G10v4nn/PPSE_Board_Code/Code/note.txt

un solo sampling rate per tutti i sensori

led accensione ogni 1/8
come salvare i dati #define max = 100
vettore struct {
    data ora sempre * +2 e data per ora legale o no

    cordinate se disponibile
    gradi 1 nord
    gradi 2 est
    altitudine

    acc x
    acc y
    acc z

    temperatura fissa
}

#define max_rate 1hr
#define min_rate 1s
sampling rate 1 ogni s 

struct dati take_data_from_GPS(){

}

struct dati take_data_from_ACC(){

}

int take_data_from_TEMP(){

}

cambiare sensibilità bottoni per sampling rate

buzzer
led
schermo da finire
USB
salvataggio stringa

Esempio sprintf:
void print_register(ICM_20948_Reg_Addr_e reg_address) {
	char buff[DIM];
	memset(buff, 0x00, DIM*sizeof(uint8_t));
	ret = HAL_I2C_Mem_Read(&hi2c1, IMU_ADDR, reg_address, 1 , (uint8_t*)buff, 1, HAL_MAX_DELAY);
	while(HAL_I2C_IsDeviceReady(&hi2c1, IMU_ADDR, 1, HAL_MAX_DELAY) != HAL_OK);
	ret = sprintf((char*)buff, "data reg: 0x%x \r\n", buff[0]);
	HAL_UART_Transmit(&huart2, (uint8_t*)buff, strlen((char*)buff), HAL_MAX_DELAY);
}
