G10v4nn/PPSE_Board_Code/PCB/PSE_RP2040/PSE_RP2040.kicad_pcb

## KiCad design PCB/PSE_RP2040/PSE_RP2040.kicad_pcb (2023-07-24)

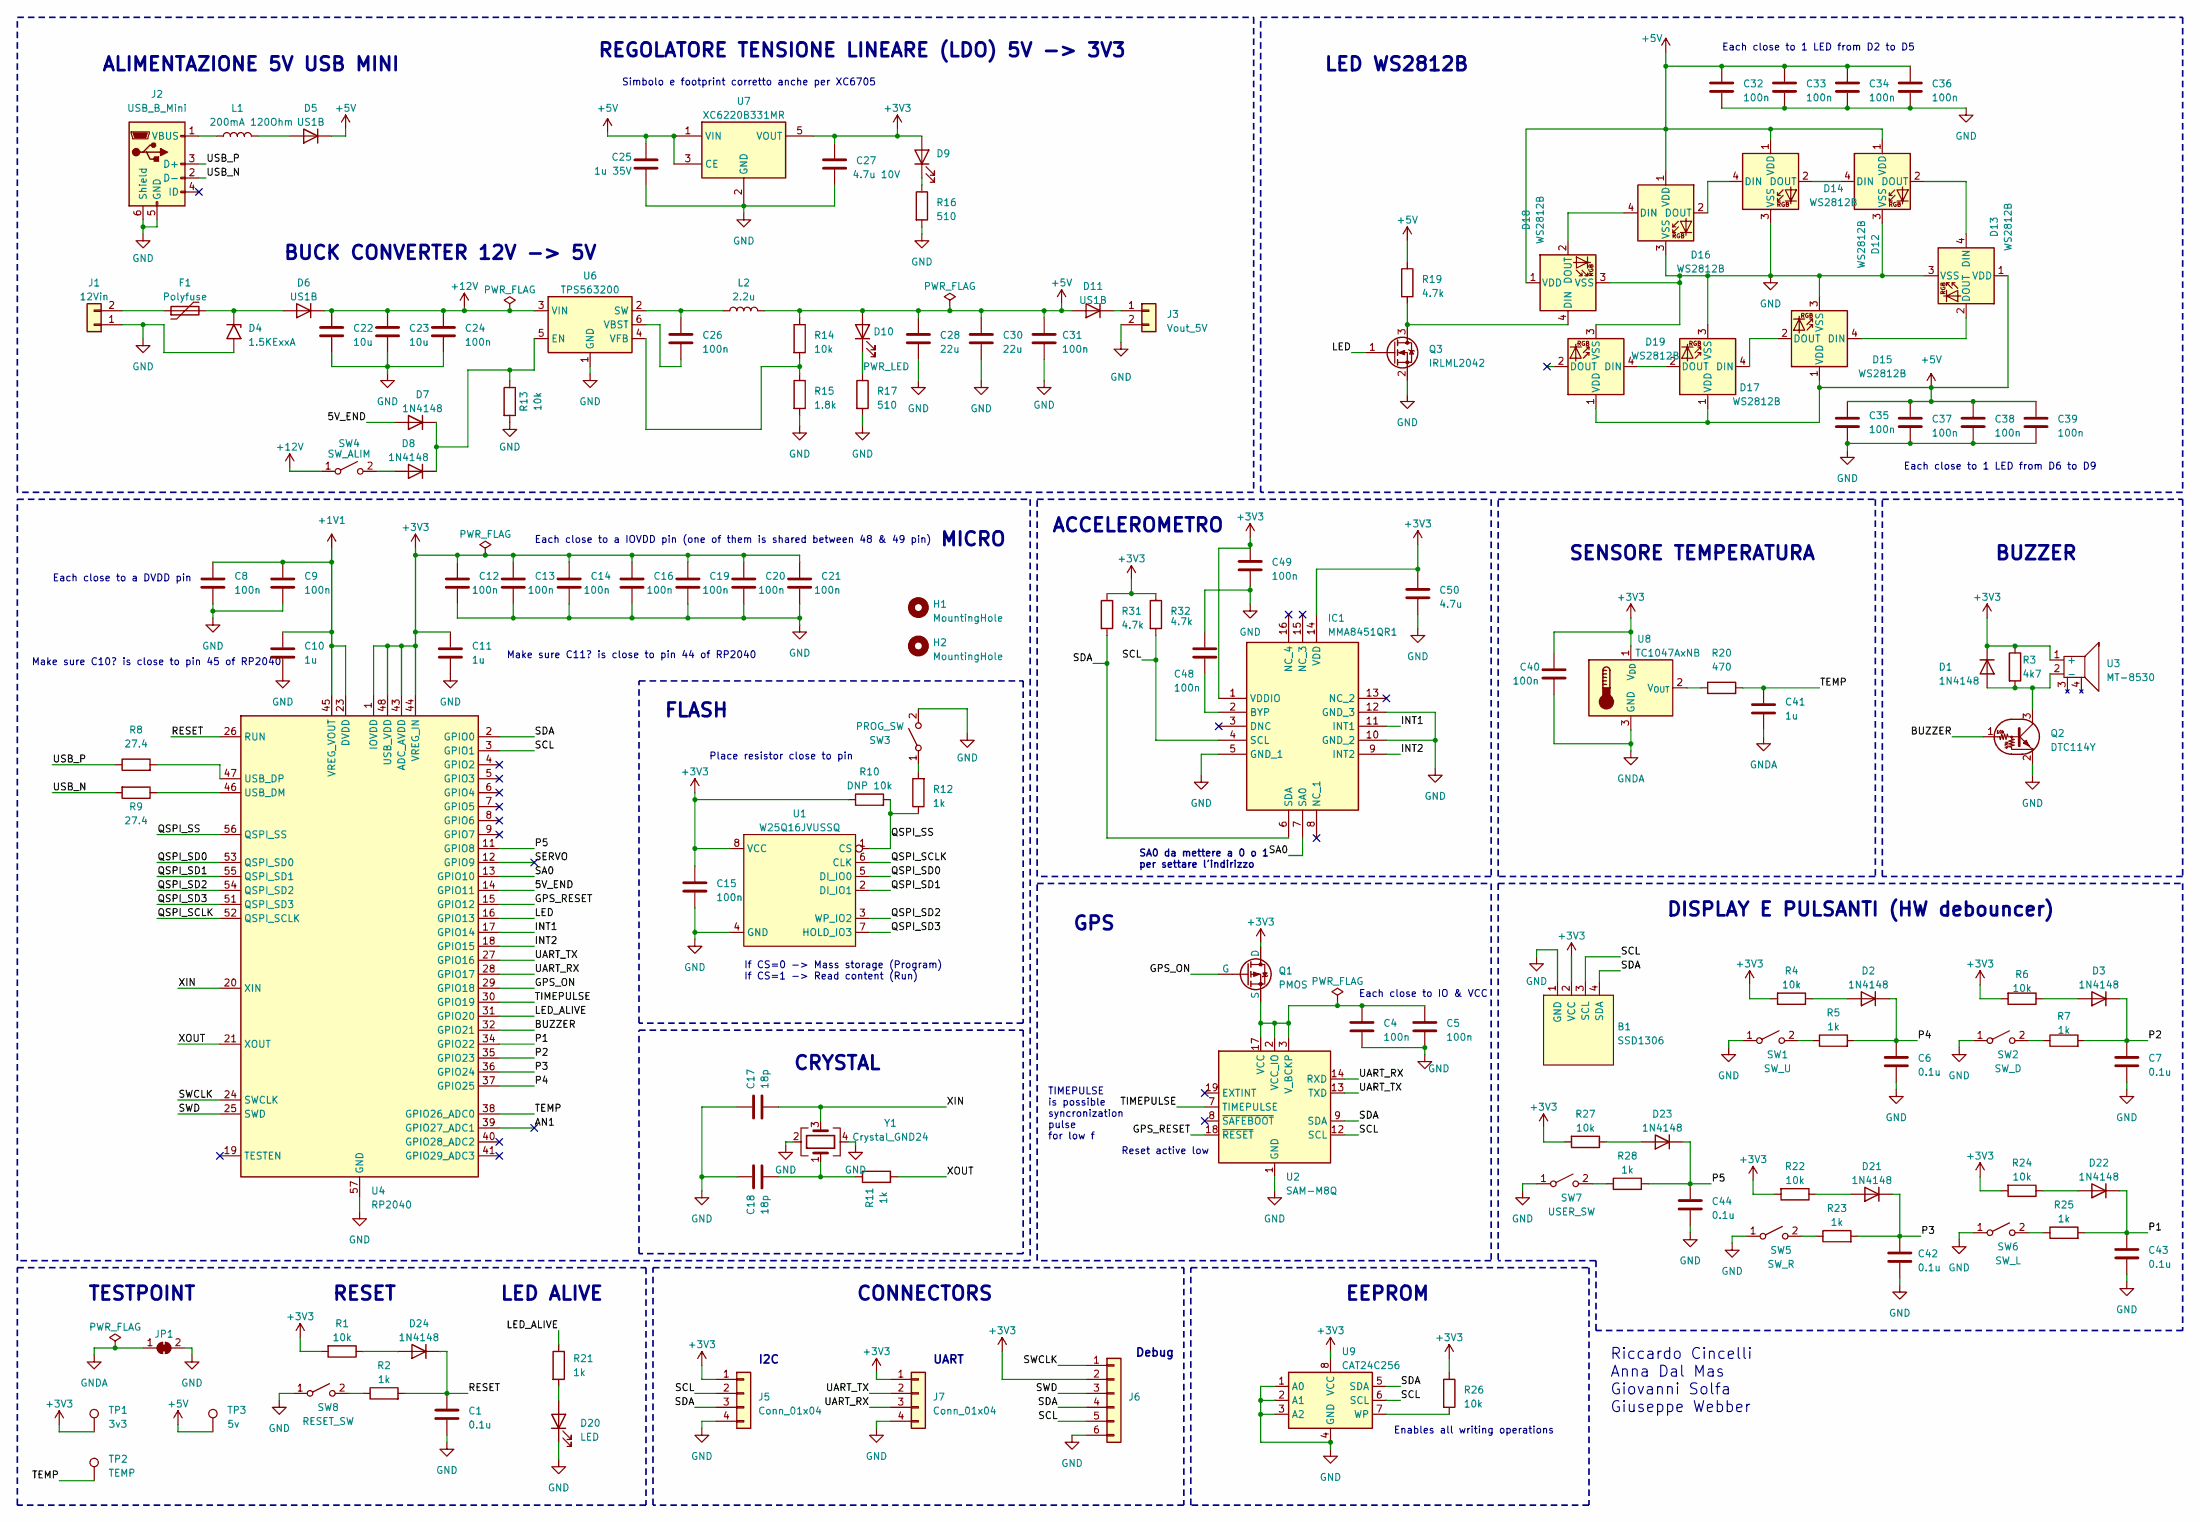
[picture p50: schematic PSE_RP2040.kicad_sch]

Parts:
B1: SSD1306; 128x64OLED
C1, C6, C7, C42, C43, C44: 0.1u; C_0603_1608Metric
C4, C5, C8, C9, C12, C13, C14, C15, C16, C19, C20, C21, C24, C26, C31, C32, C33, C34, C35, C36, C37, C38, C39, C40, C48, C49: 100n; C_0603_1608Metric
C10, C11, C41: 1u; C_0603_1608Metric
C17, C18: 18p; C_0603_1608Metric
C22, C23: 10u; CP_Radial_D6.3mm_P2.50mm
C25: 1u 35V; CP_Radial_D6.3mm_P2.50mm
C27: 4.7u 10V; CP_Radial_D6.3mm_P2.50mm
C28, C30: 22u; C_0603_1608Metric
C50: 4.7u; C_0603_1608Metric
D1, D2, D3, D7, D8, D21, D22, D23, D24: 1N4148; Nexperia_CFP3_SOD-123W
D4: 1.5KExxA; D_SMC
D5, D6, D11: US1B; D_SMA
D9, D10: PWR_LED; LED_0603_1608Metric
D12, D13, D14, D15, D16, D17, D18, D19: WS2812B; LED_WS2812B_PLCC4_5.0x5.0mm_P3.2mm
D20: LED; LED_0603_1608Metric
F1: Polyfuse; FUSC5141X200N
H1, H2: MountingHole; MountingHole_3mm
IC1: MMA8451QR1; MMA8452QT; Manufacturer_Part_Number MMA8451QR1; Mouser Part Number 841-MMA8451QR1
J1: 12Vin; 282834-2_1
J2: USB_B_Mini; USB_Mini-B_Wuerth_65100516121_Horizontal
J3: Vout_5V; 282834-2_1
J5, J7: Conn_01x04; PinSocket_1x04_P2.54mm_Vertical
J6: Conn_01x06; PinSocket_1x06_P2.54mm_Vertical
JP1: SolderJumper_2_Bridged; SolderJumper-2_P1.3mm_Bridged_Pad1.0x1.5mm
L1: 200mA 120Ohm; L_0603_1608Metric
L2: 2.2u; LQH44PN100MJ0L
Q1: PMOS; SOT95P237X112-3N
Q2: DTC114Y; SOT-23
Q3: IRLML2042; SOT-23
R1, R4, R6, R13, R14, R22, R24, R26, R27: 10k; R_0603_1608Metric
R2, R5, R7, R11, R12, R21, R23, R25, R28: 1k; R_0603_1608Metric
R3: 4k7; R_0603_1608Metric
R8, R9: 27.4; R_0603_1608Metric
R10: DNP 10k; R_0603_1608Metric
R15: 1.8k; R_0603_1608Metric
R16, R17: 510; R_0603_1608Metric
R19, R31, R32: 4.7k; R_0603_1608Metric
R20: 470; R_0603_1608Metric
SW1: SW_U; SW_PUSH_6mm_H5mm
SW2: SW_D; SW_PUSH_6mm_H5mm
SW3: PROG_SW; SW_PUSH_6mm_H5mm
SW4: SW_ALIM; SW_PUSH_6mm_H5mm
SW5: SW_R; SW_PUSH_6mm_H5mm
SW6: SW_L; SW_PUSH_6mm_H5mm
SW7: USER_SW; SW_PUSH_6mm_H5mm
SW8: RESET_SW; SW_PUSH_6mm_H5mm
TP1: 3v3; TestPoint_Keystone_5005-5009_Compact
TP2: TEMP; TestPoint_Keystone_5005-5009_Compact
TP3: 5v; TestPoint_Keystone_5005-5009_Compact
U1: W25Q16JVUSSQ; SOIC127P600X175-8N
U2: SAM-M8Q; ublox_SAM-M8Q
U3: MT-8530
U4: RP2040; QFN-56-1EP_7x7mm_P0.4mm_EP3.2x3.2mm
U6: TPS563200; SOT-23-6
U7: XC6220B331MR; SOT-23-5
U8: TC1047AxNB; SOT-23
U9: CAT24C256; SOIC127P790X216-8N
Y1: Crystal_GND24; Crystal_SMD_3225-4Pin_3.2x2.5mm_HandSoldering

Connections:
+1V1: C8.1, C9.1, C10.1, U4.23 (DVDD), U4.45 (VREG_VOUT), U4.50 (DVDD)
+3V3: B1.2 (VCC), C11.1, C12.1, C13.1, C14.1, C15.1, C16.1, C19.1, C20.1, C21.1, C27.1, C40.1, C49.1, C50.1, D1.1 (K), D9.2 (A), IC1.1 (VDDIO), IC1.14 (VDD), J5.1, J6.2, J7.1, Q1.1 (D), R1.2, R3.1, R4.2, R6.2, R10.1, R22.2, R24.2, R26.1, R27.2, R31.1, R32.1, TP1.1, U1.8 (VCC), U3.1 (+), U4.1 (IOVDD), U4.10 (IOVDD), U4.22 (IOVDD), U4.33 (IOVDD), U4.42 (IOVDD), U4.43 (ADC_AVDD), U4.44 (VREG_IN), U4.48 (USB_VDD), U4.49 (IOVDD), U7.5 (VOUT), U8.1 (V_{DD}), U9.8 (VCC)
+5V: C25.1, C28.1, C30.1, C31.1, C32.1, C33.1, C34.1, C35.1, C36.1, C37.1, C38.1, C39.1, D5.1 (K), D10.2 (A), D11.2 (A), D12.1 (VDD), D13.1 (VDD), D14.1 (VDD), D15.1 (VDD), D16.1 (VDD), D17.1 (VDD), D18.1 (VDD), D19.1 (VDD), L2.2, R14.1, R19.1, TP3.1, U7.1 (VIN), U7.3 (CE)
+12V: C22.1, C23.1, C24.1, D6.1 (K), SW4.1 (A), U6.3 (VIN)
/5V_END: D7.2 (A), U4.14 (GPIO11)
/AN1: U4.39 (GPIO27_ADC1)
/BUZZER: Q2.1 (B), U4.32 (GPIO21)
/GPS_ON: Q1.2 (G), U4.29 (GPIO18)
/GPS_RESET: U2.18 (~RESET), U4.15 (GPIO12)
/INT1: IC1.11 (INT1), U4.17 (GPIO14)
/INT2: IC1.9 (INT2), U4.18 (GPIO15)
/LED: Q3.1 (G), U4.16 (GPIO13)
/LED_ALIVE: R21.1, U4.31 (GPIO20)
/P1: C43.1, D22.1 (K), R25.2, U4.34 (GPIO22)
/P2: C7.1, D3.1 (K), R7.2, U4.35 (GPIO23)
/P3: C42.1, D21.1 (K), R23.2, U4.36 (GPIO24)
/P4: C6.1, D2.1 (K), R5.2, U4.37 (GPIO25)
/P5: C44.1, D23.1 (K), R28.2, U4.11 (GPIO8)
/QSPI_SCLK: U1.6 (CLK), U4.52 (QSPI_SCLK)
/QSPI_SD0: U1.5 (DI_IO0), U4.53 (QSPI_SD0)
/QSPI_SD1: U1.2 (DI_IO1), U4.55 (QSPI_SD1)
/QSPI_SD2: U1.3 (WP_IO2), U4.54 (QSPI_SD2)
/QSPI_SD3: U1.7 (HOLD_IO3), U4.51 (QSPI_SD3)
/QSPI_SS: R10.2, R12.1, U1.1 (CS), U4.56 (QSPI_SS)
/RESET: C1.1, D24.1 (K), R2.2, U4.26 (RUN)
/SA0: IC1.7 (SA0), U4.13 (GPIO10)
/SCL: B1.3 (SCL), IC1.4 (SCL), J5.2, J6.5, R32.2, U2.12 (SCL), U4.3 (GPIO1), U9.6 (SCL)
/SDA: B1.4 (SDA), IC1.6 (SDA), J5.3, J6.4, R31.2, U2.9 (SDA), U4.2 (GPIO0), U9.5 (SDA)
/SERVO: U4.12 (GPIO9)
/SWCLK: J6.1, U4.24 (SWCLK)
/SWD: J6.3, U4.25 (SWD)
/TEMP: C41.1, R20.2, TP2.1, U4.38 (GPIO26_ADC0)
/TIMEPULSE: U2.7 (TIMEPULSE), U4.30 (GPIO19)
/UART_RX: J7.3, U2.14 (RXD), U4.28 (GPIO17)
/UART_TX: J7.2, U2.13 (TXD), U4.27 (GPIO16)
/USB_N: J2.2 (D-), R9.2
/USB_P: J2.3 (D+), R8.1
/XIN: C17.2, U4.20 (XIN), Y1.3
/XOUT: R11.2, U4.21 (XOUT)
GND: B1.1 (GND), C1.2, C4.2, C5.2, C6.2, C7.2, C8.2, C9.2, C10.2, C11.2, C12.2, C13.2, C14.2, C15.2, C16.2, C17.1, C18.1, C19.2, C20.2, C21.2, C22.2, C23.2, C24.2, C25.2, C27.2, C28.2, C30.2, C31.2, C32.2, C33.2, C34.2, C35.2, C36.2, C37.2, C38.2, C39.2, C42.2, C43.2, C44.2, C48.1, C49.2, C50.2, D4.2 (A2), D12.3 (VSS), D13.3 (VSS), D14.3 (VSS), D15.3 (VSS), D16.3 (VSS), D17.3 (VSS), D18.3 (VSS), D19.3 (VSS), D20.1 (K), IC1.5 (GND_1), IC1.10 (GND_2), IC1.12 (GND_3), J1.1, J2.5 (GND), J2.6 (Shield), J3.2, J5.4, J6.6, J7.4, JP1.2 (B), Q2.2 (E), Q3.2 (S), R13.2, R15.2, R16.2, R17.2, SW1.1 (A), SW2.1 (A), SW3.2 (B), SW5.1 (A), SW6.1 (A), SW7.1 (A), SW8.1 (A), U1.4 (GND), U2.1 (GND), U2.4 (GND), U2.5 (GND), U2.6 (GND), U2.10 (GND), U2.11 (GND), U2.15 (GND), U2.16 (GND), U2.20 (GND), U4.57 (GND), U6.1 (GND), U7.2 (GND), U9.1 (A0), U9.2 (A1), U9.3 (A2), U9.4 (GND), Y1.2, Y1.4
GNDA: C40.2, C41.2, JP1.1 (A), U8.3 (GND)
unnamed: C18.2, R11.1, Y1.1
unnamed: D1.2 (A), Q2.3 (C), R3.2, U3.2 (-)
unnamed: D2.2 (A), R4.1
unnamed: D3.2 (A), R6.1
unnamed: D4.1 (A1), D6.2 (A), F1.2
unnamed: D5.2 (A), L1.2
unnamed: D7.1 (K), D8.1 (K), R13.1, U6.5 (EN)
unnamed: D8.2 (A), SW4.2 (B)
unnamed: D9.1 (K), R16.1
unnamed: D10.1 (K), R17.1
unnamed: D11.1 (K), J3.1
unnamed: D12.4 (DIN), D14.2 (DOUT)
unnamed: D12.2 (DOUT), D13.4 (DIN)
unnamed: D13.2 (DOUT), D15.4 (DIN)
unnamed: D14.4 (DIN), D16.2 (DOUT)
unnamed: D15.2 (DOUT), D17.4 (DIN)
unnamed: D16.4 (DIN), D18.2 (DOUT)
unnamed: D17.2 (DOUT), D19.4 (DIN)
unnamed: D18.4 (DIN), Q3.3 (D), R19.2
unnamed: D20.2 (A), R21.2
unnamed: D21.2 (A), R22.1
unnamed: D22.2 (A), R24.1
unnamed: D23.2 (A), R27.1
unnamed: D24.2 (A), R1.1
unnamed: C48.2, IC1.2 (BYP)
unnamed: F1.1, J1.2
unnamed: J2.1 (VBUS), L1.1
unnamed: C4.1, C5.1, Q1.3 (S), U2.2 (VCC_IO), U2.3 (V_BCKP), U2.17 (VCC)
unnamed: R5.1, SW1.2 (B)
unnamed: R7.1, SW2.2 (B)
unnamed: R12.2, SW3.1 (A)
unnamed: R23.1, SW5.2 (B)
unnamed: R25.1, SW6.2 (B)
unnamed: R28.1, SW7.2 (B)
unnamed: R2.1, SW8.2 (B)
unnamed: R9.1, U4.46 (USB_DM)
unnamed: R8.2, U4.47 (USB_DP)
unnamed: C26.1, L2.1, U6.2 (SW)
unnamed: C26.2, U6.6 (VBST)
unnamed: R14.2, R15.1, U6.4 (VFB)
unnamed: R20.1, U8.2 (V_{OUT})
unnamed: R26.2, U9.7 (WP)

Notes on the sheet:
Reset active low
DISPLAY E PULSANTI (HW debouncer)
Each close to IO & VCC
ALIMENTAZIONE 5V USB MINI
RESET
LED ALIVE
I2C
Make sure C10? is close to pin 45 of RP2040
FLASH
If CS=0 -> Mass storage (Program) If CS=1 -> Read content (Run)
REGOLATORE TENSIONE LINEARE (LDO) 5V -> 3V3
Each close to a DVDD pin
Each close to 1 LED from D6 to D9
TIMEPULSE is possible syncronization pulse for low f
Place resistor close to pin
Make sure C11? is close to pin 44 of RP2040
BUZZER
Enables all writing operations
Each close to a IOVDD pin (one of them is shared between 48 & 49 pin)
BUCK CONVERTER 12V -> 5V
Debug
MICRO
Each close to 1 LED from D2 to D5
SA0 da mettere a 0 o 1 per settare l'indirizzo
SENSORE TEMPERATURA
Simbolo e footprint corretto anche per XC6705
CONNECTORS
UART
GPS
ACCELEROMETRO
CRYSTAL
EEPROM
Riccardo Cincelli Anna Dal Mas Giovanni Solfa Giuseppe Webber
LED WS2812B
TESTPOINT

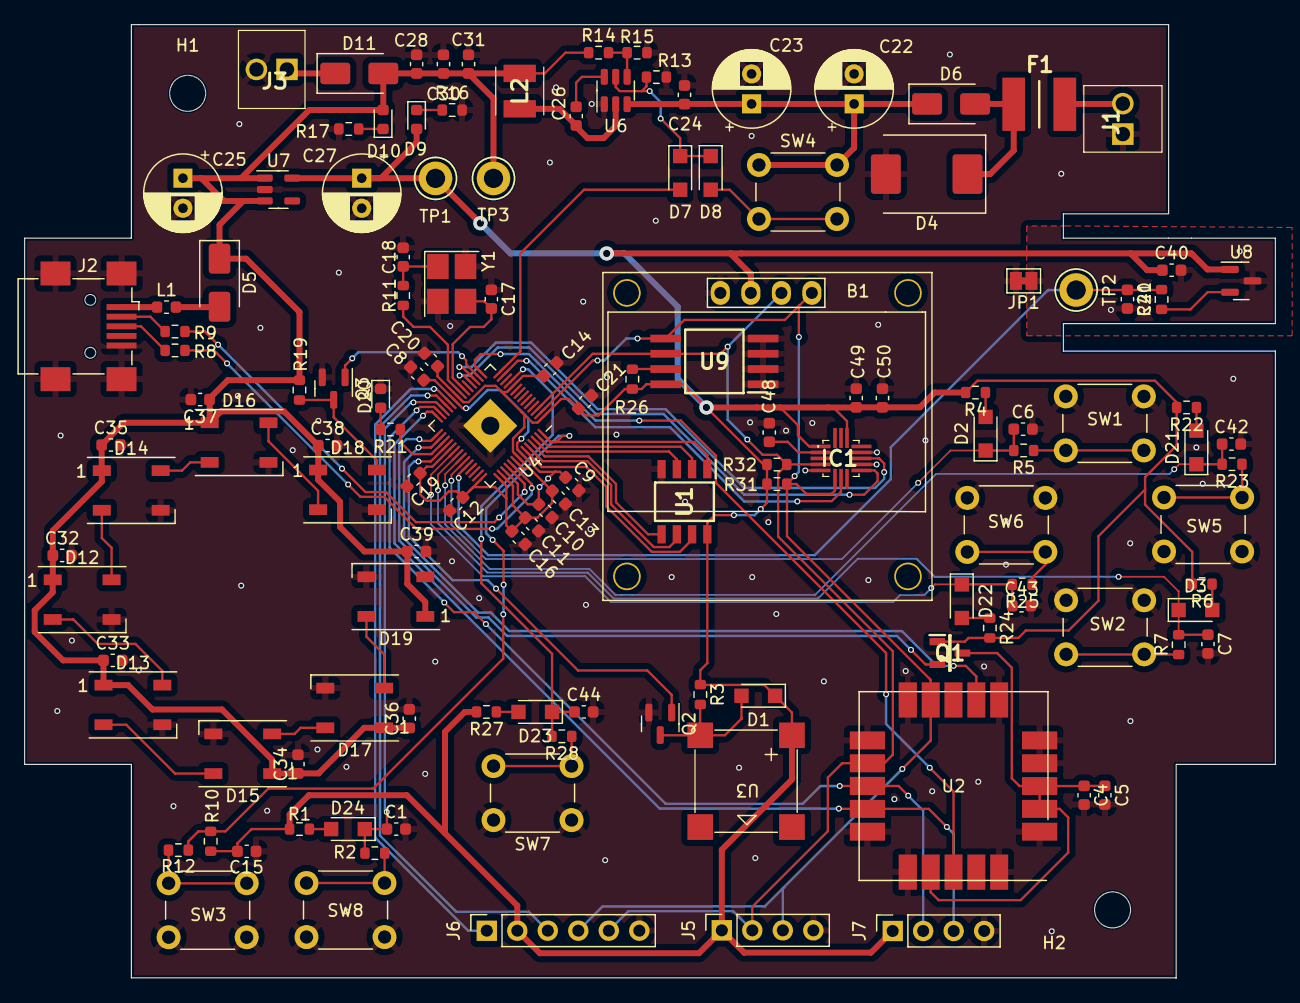
[picture p51: board PSE_RP2040.kicad_pcb from above]

Board: 2 copper layers, 104.1 x 79.4 mm, 134 parts (0 on the bottom side), 81 nets.
