G10v4nn/PPSE_Board_Code/Code/cdc_msc/Data.h

#ifndef __USB_DATA__
#define __USB_DATA__
#include "msc_disk.c"
/*
 */

/*
"DATA, ORA, LATITUDINE, LONGITUDINE, ALTITUDINE, ACCELEROMETRO X, ACCELEROMETRO Y, ACCELEROMETRO Z, TEMPERATURA \r\n\r\n\
12/05/2001, 15:02:56, 01105.12345N, 01105.12345E, 01105.12345E, 34.20 m/s, 34.20 m/s,  34.20 m/s, -15.00C \r\n\
12/05/2001, 15:02:56, 01105.12345N, 01105.12345E, 01105.12345E, 34.20 m/s, 34.20 m/s,  34.20 m/s, -15.00C \r\n"; 
*/

#ifdef CFG_EXAMPLE_MSC_READONLY
const
#endif
#define DISK_BLOCK_NUM 32
#define DISK_BLOCK_SIZE 512
char README_CONTENTS [29*512];

uint8_t msc_disk[DISK_BLOCK_NUM][DISK_BLOCK_SIZE] =
{
  //------------- Block0: Boot Sector -------------//
  // byte_per_sector    = DISK_BLOCK_SIZE; fat12_sector_num_32  = DISK_BLOCK_NUM;
  // sector_per_cluster = 1; reserved_sectors = 1;
  // fat_num            = 1; fat12_root_entry_num = 32;
  // sector_per_fat     = 1; sector_per_track = 1; head_num = 1; hidden_sectors = 0;
  // drive_number       = 0x80; media_type = 0xf8; extended_boot_signature = 0x29;
  // filesystem_type    = "FAT12   "; volume_serial_number = 0x1234; volume_label = "TinyUSB MSC";
  // FAT magic code at offset 510-511
  {
      0xEB, 0x3C, 0x90, 0x4D, 0x53, 0x44, 0x4F, 0x53, 0x35, 0x2E, 0x30, 0x00, 0x02, 0x01, 0x01, 0x00,
      0x01, 0x10, 0x00, 0x20, 0x00, 0xF8, 0x01, 0x00, 0x01, 0x00, 0x01, 0x00, 0x00, 0x00, 0x00, 0x00, // the 0x20 and the one on the right indicates the size of the MSC
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
        0x09, 0xA0, 0x00,   0x0B, 0xC0, 0x00, 
        0x0D, 0xE0, 0x00,   0x0F, 0x00, 0x01,
        0x11, 0x20, 0x01,   0x13, 0x40, 0x01,
        0x15, 0x60, 0x01,   0x17, 0x80, 0x01,
        0x19, 0xA0, 0x01,   0x1B, 0xC0, 0x01,
        0xFF, 0x0F // file termination
  },

  //------------- Block2: Root Directory -------------//
  {
      // first entry is volume label
      'T' , 'i' , 'n' , 'y' , 'U' , 'S' , 'B' , ' ' , 'M' , 'S' , 'C' , 0x08, 0x00, 0x00, 0x00, 0x00,
      0x00, 0x00, 0x00, 0x00, 0x00, 0x00, 0x4F, 0x6D, 0x65, 0x43, 0x00, 0x00, 0x00, 0x00, 0x00, 0x00,
      // second entry is readme file
      'R' , 'E' , 'A' , 'D' , 'M' , 'E' , ' ' , ' ' , 'T' , 'X' , 'T' , 0x20, 0x00, 0xC6, 0x52, 0x6D,
      0x65, 0x43, 0x65, 0x43, 0x00, 0x00, 0x88, 0x6D, 0x65, 0x43, 0x02, 0x00,
      0xF8, 0x2B, 0x00, 0x00 // readme's files size
  },
  //------------- Block3: Readme Content -------------//
};
#endif
