G10v4nn/PPSE_Board_Code/Code/buzzer.h

#ifndef BUZZER_INCLUDED
#define BUZZER_INCLUDED

void init_buzzer(void);
void click_button(void);
void end_menu(void);
void exit_nosave(void);
void exit_save(void);
void end_acquisition(void);

#endif
