G10v4nn/PPSE_Board_Code/Code/temperature.c

/**
 * Copyright (c) 2020 Raspberry Pi (Trading) Ltd.
 *
 * SPDX-License-Identifier: BSD-3-Clause
 */

#include <stdio.h>
#include "pico/stdlib.h"
#include "hardware/gpio.h"
#include "hardware/adc.h"

#include "datatypes.h"
#include "temperature.h"

void init_temperature(){
    adc_init();
    // Make sure GPIO is high-impedance, no pullups etc
    adc_gpio_init(26);
    // Select ADC input 0 (GPIO26)
    adc_select_input(0);
    adc_set_clkdiv(500);
}

void get_temperature(struct Data_storage *Data){
    // 12-bit conversion, assume max value == ADC_VREF == 3.3 V
    const float conversion_factor = 3.3f / (1 << 12);
    uint16_t result = adc_read();
    float temperature = (result*conversion_factor - 0.5)/0.01;
    Data->temperature = temperature;
}
