G10v4nn/PPSE_Board_Code/(commit log)

2023-06-05 tiny_usb add
    [rp2040-openocd.cfg, wch-riscv.cfg]
2023-06-06 more example: i2c scan, accelerometer
    [mma8451_i2c.fzz]
2023-06-07 gitignore fixing
    [mma8451_i2c.fzz, rp2040-openocd.cfg, wch-riscv.cfg]
2023-06-07 reload files
    [mma8451_i2c.fzz, rp2040-openocd.cfg, wch-riscv.cfg]
2023-06-11 fixed i2c pin for IMU
2023-06-11 added accelerometer files
2023-06-12 included .c and .h sensors. with init and get functions
2023-06-13 added ringtones for buzzer
    [buzzer.c, buzzer.h]
2023-06-13 added led files, removed useless files
2023-06-13 added buttons sounds
2023-06-15 alleluja, final push (si spera)
    [mma8451_i2c.fzz, rp2040-openocd.cfg, wch-riscv.cfg]
2023-07-24 Added kicad files
    [PSE_RP2040.kicad_pcb, PSE_RP2040.kicad_sch]
